hacker-fab/uw-spincoater/schematic/Spin_Coater.kicad_pcb

## KiCad design schematic/Spin_Coater.kicad_pcb (2026-05-23)

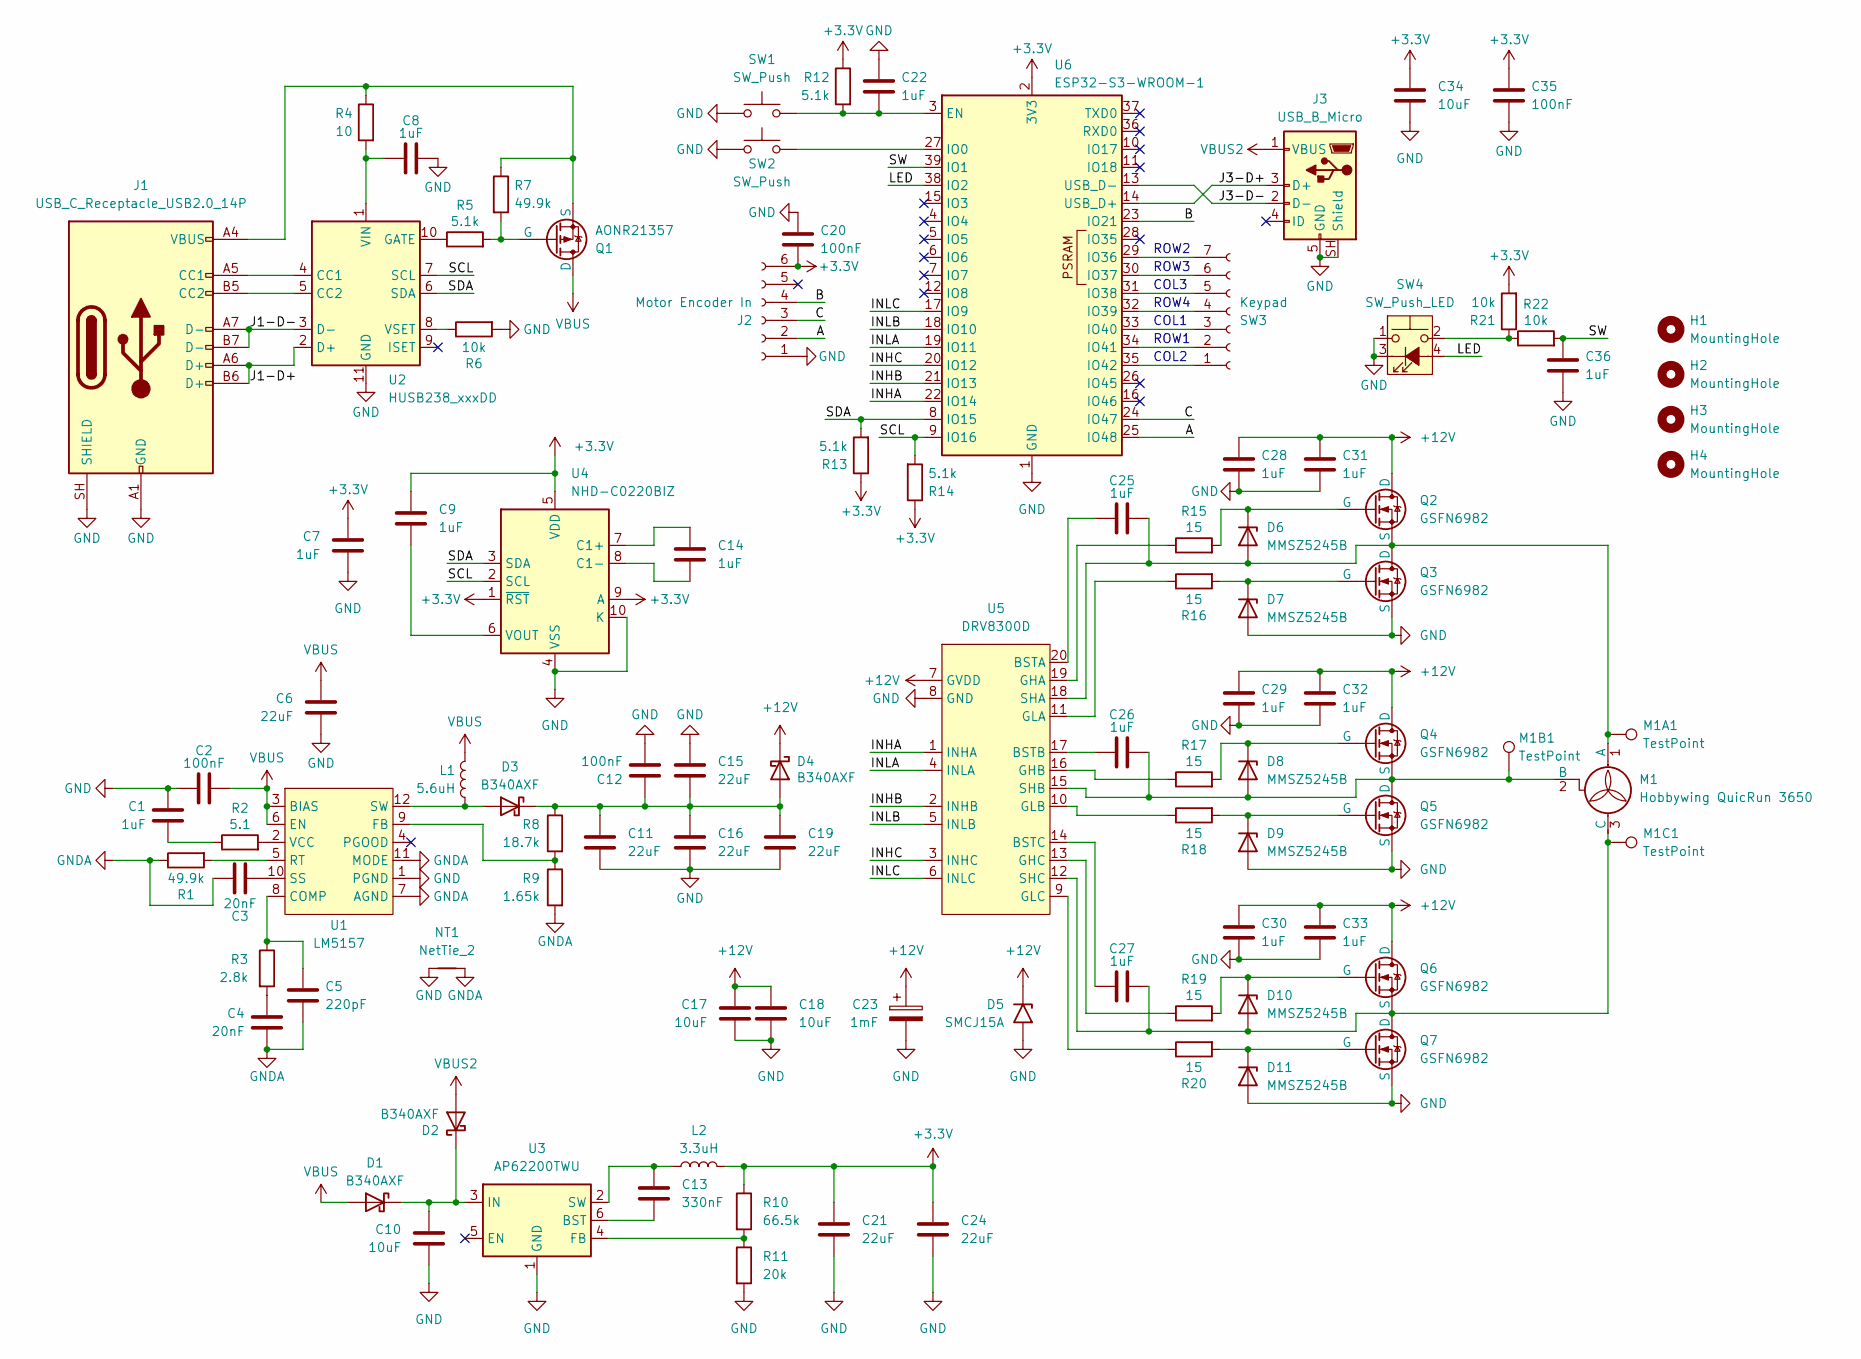
[picture p1: schematic Spin_Coater.kicad_sch, BLDC Proto]

Parts:
C1, C7, C8, C9, C14, C22, C25, C26, C27, C28, C29, C30, C31, C32, C33, C36: 1uF; C_0805_2012Metric
C2, C12, C20, C35: 100nF; C_0805_2012Metric
C3, C4: 20nF; C_0805_2012Metric
C5: 220pF; C_0805_2012Metric
C6, C11, C15, C16, C19, C21, C24: 22uF; C_1210_3225Metric
C10, C17, C18, C34: 10uF; C_1206_3216Metric
C13: 330nF; C_0805_2012Metric
C23: 1mF; CP_Radial_D13.0mm_P5.00mm
D1, D2, D3, D4: B340AXF; D_SMA
D5: SMCJ15A; D_SMC
D6, D7, D8, D9, D10, D11: MMSZ5245B; D_SOD-123
H1, H2, H3, H4: MountingHole; MountingHole_3.2mm_M3
J1: USB_C_Receptacle_USB2.0_14P; UJ20-C-H-G-SMT-2A-P16-TR
J2: Motor Encoder In; JST_ZH_B6B-ZR_1x06_P1.50mm_Vertical
J3: USB_B_Micro; UJ2-MIBH-G-SMT-TR
L1: 5.6uH; HPAL1V0630
L2: 3.3uH; HPC5040NF
M1: Hobbywing QuicRun 3650
M1A1, M1B1, M1C1: TestPoint; TestPoint_THTPad_D5.5mm_Drill3.5mm
NT1: NetTie_2; NetTie-2_SMD_Pad0.25mm
Q1: AONR21357; PPAK3x3
Q2, Q3, Q4, Q5, Q6, Q7: GSFN6982; PPAK3x3
R1, R7: 49.9k; R_0805_2012Metric
R2: 5.1; R_0805_2012Metric
R3: 2.8k; R_0805_2012Metric
R4: 10; R_0805_2012Metric
R5, R12, R13, R14: 5.1k; R_0805_2012Metric
R6, R21, R22: 10k; R_0805_2012Metric
R8: 18.7k; R_0805_2012Metric
R9: 1.65k; R_0805_2012Metric
R10: 66.5k; R_0805_2012Metric
R11: 20k; R_0805_2012Metric
R15, R16, R17, R18, R19, R20: 15; R_0805_2012Metric
SW1, SW2: SW_Push; SW_PUSH_6mm
SW3: Keypad; PinHeader_1x07_P2.54mm_Vertical
SW4: SW_Push_LED; PinSocket_2x02_P2.54mm_Vertical
U1: LM5157; WQFN-16-1EP_3x3mm_P0.5mm_EP1.68x1.68mm_ThermalVias
U2: HUSB238_xxxDD; WDFN-10-1EP_3x3mm_P0.5mm_EP1.8x2.5mm
U3: AP62200TWU; TSOT-23-6
U4: NHD-C0220BIZ; NHD-C0220BiZ
U5: DRV8300D; TSSOP-20_4.4x6.5mm_P0.65mm
U6: ESP32-S3-WROOM-1

Connections:
+3.3V: C7.1, C9.1, C20.2, C21.1, C24.1, C34.1, C35.1, J2.6, L2.2, R10.1, R12.1, R13.1, R14.1, R21.2, U4.1 (~RST), U4.5 (VDD), U4.9 (A), U6.2 (3V3)
+12V: C17.1, C18.1, C23.1, C28.1, C29.1, C30.1, C31.1, C32.1, C33.1, D4.1 (K), D5.1 (A1), Q2.5 (D), Q4.5 (D), Q6.5 (D), U5.7 (GVDD)
/A: J2.2, U6.25 (IO48)
/B: J2.4, U6.23 (IO21)
/C: J2.3, U6.24 (IO47)
/INHA: U5.1 (INHA), U6.22 (IO14)
/INHB: U5.2 (INHB), U6.21 (IO13)
/INHC: U5.3 (INHC), U6.20 (IO12)
/INLA: U5.4 (INLA), U6.19 (IO11)
/INLB: U5.5 (INLB), U6.18 (IO10)
/INLC: U5.6 (INLC), U6.17 (IO9)
/J1-D+: J1.A6 (D+), J1.B6 (D+), U2.2 (D+)
/J1-D-: J1.A7 (D-), J1.B7 (D-), U2.3 (D-)
/J3-D+: J3.3 (D+), U6.14 (USB_D+)
/J3-D-: J3.2 (D-), U6.13 (USB_D-)
/LED: SW4.4 (A), U6.38 (IO2)
/SCL: R14.2, U2.7 (SCL), U4.2 (SCL), U6.9 (IO16)
/SDA: R13.2, U2.6 (SDA), U4.3 (SDA), U6.8 (IO15)
/SW: C36.1, R22.2, U6.39 (IO1)
GND: C1.1, C2.1, C6.2, C7.2, C8.2, C10.2, C11.2, C12.2, C15.1, C16.2, C17.2, C18.2, C19.2, C20.1, C21.2, C22.1, C23.2, C24.2, C28.2, C29.2, C30.2, C31.2, C32.2, C33.2, C34.2, C35.2, C36.2, D5.2 (A2), D7.2 (A), D9.2 (A), D11.2 (A), J1.A1 (GND), J1.A12 (GND), J1.B1 (GND), J1.B12 (GND), J1.SH (SHIELD), J2.1, J3.5 (GND), J3.SH (Shield), NT1.1, Q3.1 (S), Q3.2 (S), Q3.3 (S), Q5.1 (S), Q5.2 (S), Q5.3 (S), Q7.1 (S), Q7.2 (S), Q7.3 (S), R6.2, R11.2, SW1.1, SW2.1, SW4.1, SW4.3 (K), U1.1 (PGND), U1.16 (PGND), U1.17 (PGND), U2.11 (GND), U3.1 (GND), U4.4 (VSS), U4.10 (K), U5.8 (GND), U6.1 (GND), U6.40 (GND), U6.41 (GND)
GNDA: C3.1, C4.2, C5.2, NT1.2, R1.1, R9.2, U1.7 (AGND), U1.11 (MODE)
unnamed: C1.2, R2.1
unnamed: C4.1, R3.2
unnamed: C10.1, D1.1 (K), D2.1 (K), U3.3 (IN)
unnamed: D3.2 (A), L1.2, U1.12 (SW), U1.13 (SW), U1.14 (SW)
unnamed: C11.1, C12.1, C15.2, C16.1, C19.1, D3.1 (K), D4.2 (A), R8.1
unnamed: C25.2, D6.2 (A), M1.1 (A), M1A1.1 (1_1), Q2.1 (S), Q2.2 (S), Q2.3 (S), Q3.5 (D), U5.18 (SHA)
unnamed: D6.1 (K), Q2.4 (G), R15.2
unnamed: D7.1 (K), Q3.4 (G), R16.2
unnamed: C26.2, D8.2 (A), M1.2 (B), M1B1.1 (1_1), Q4.1 (S), Q4.2 (S), Q4.3 (S), Q5.5 (D), U5.15 (SHB)
unnamed: D8.1 (K), Q4.4 (G), R17.2
unnamed: D9.1 (K), Q5.4 (G), R18.2
unnamed: C27.2, D10.2 (A), M1.3 (C), M1C1.1 (1_1), Q6.1 (S), Q6.2 (S), Q6.3 (S), Q7.5 (D), U5.12 (SHC)
unnamed: D10.1 (K), Q6.4 (G), R19.2
unnamed: D11.1 (K), Q7.4 (G), R20.2
unnamed: J1.A5 (CC1), U2.4 (CC1)
unnamed: J1.B5 (CC2), U2.5 (CC2)
unnamed: J1.A4 (VBUS), J1.A9 (VBUS), J1.B4 (VBUS), J1.B9 (VBUS), Q1.1 (S), Q1.2 (S), Q1.3 (S), R4.1, R7.1
unnamed: Q1.4 (G), R5.2, R7.2
unnamed: R21.1, R22.1, SW4.2
unnamed: SW3.1, U6.35 (IO42)
unnamed: SW3.2, U6.34 (IO41)
unnamed: SW3.3, U6.33 (IO40)
unnamed: SW3.4, U6.32 (IO39)
unnamed: SW3.5, U6.31 (IO38)
unnamed: SW3.6, U6.30 (IO37)
unnamed: SW3.7, U6.29 (IO36)
unnamed: C5.1, R3.1, U1.8 (COMP)
unnamed: R8.2, R9.1, U1.9 (FB)
unnamed: R1.2, U1.5 (RT)
unnamed: C3.2, U1.10 (SS)
unnamed: R2.2, U1.2 (VCC)
unnamed: R5.1, U2.10 (GATE)
unnamed: C8.1, R4.2, U2.1 (VIN)
unnamed: R6.1, U2.8 (VSET)
unnamed: C13.2, U3.6 (BST)
unnamed: R10.2, R11.1, U3.4 (FB)
unnamed: C13.1, L2.1, U3.2 (SW)
unnamed: C14.1, U4.7 (C1+)
unnamed: C14.2, U4.8 (C1-)
unnamed: C9.2, U4.6 (VOUT)
unnamed: C25.1, U5.20 (BSTA)
unnamed: C26.1, U5.17 (BSTB)
unnamed: C27.1, U5.14 (BSTC)
unnamed: R15.1, U5.19 (GHA)
unnamed: R17.1, U5.16 (GHB)
unnamed: R19.1, U5.13 (GHC)
unnamed: R16.1, U5.11 (GLA)
unnamed: R18.1, U5.10 (GLB)
unnamed: R20.1, U5.9 (GLC)
unnamed: C22.2, R12.2, SW1.2, U6.3 (EN)
unnamed: SW2.2, U6.27 (IO0)
VBUS: C2.2, C6.1, D1.2 (A), L1.1, Q1.5 (D), U1.3 (BIAS), U1.6 (EN)
VBUS2: D2.2 (A), J3.1 (VBUS)

Notes on the sheet:
ROW2
COL2
ROW3
ROW4
COL3
COL1
ROW1

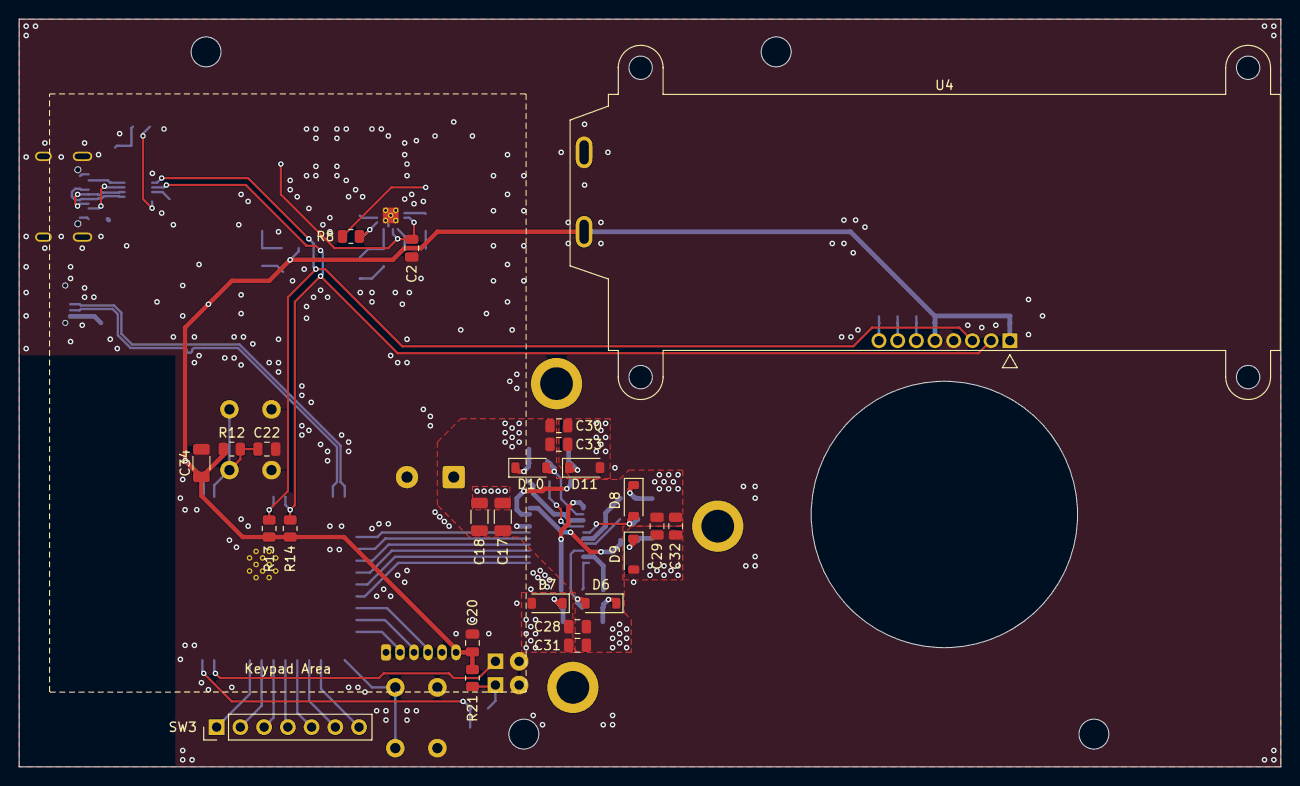
[picture p2: board Spin_Coater.kicad_pcb from above]

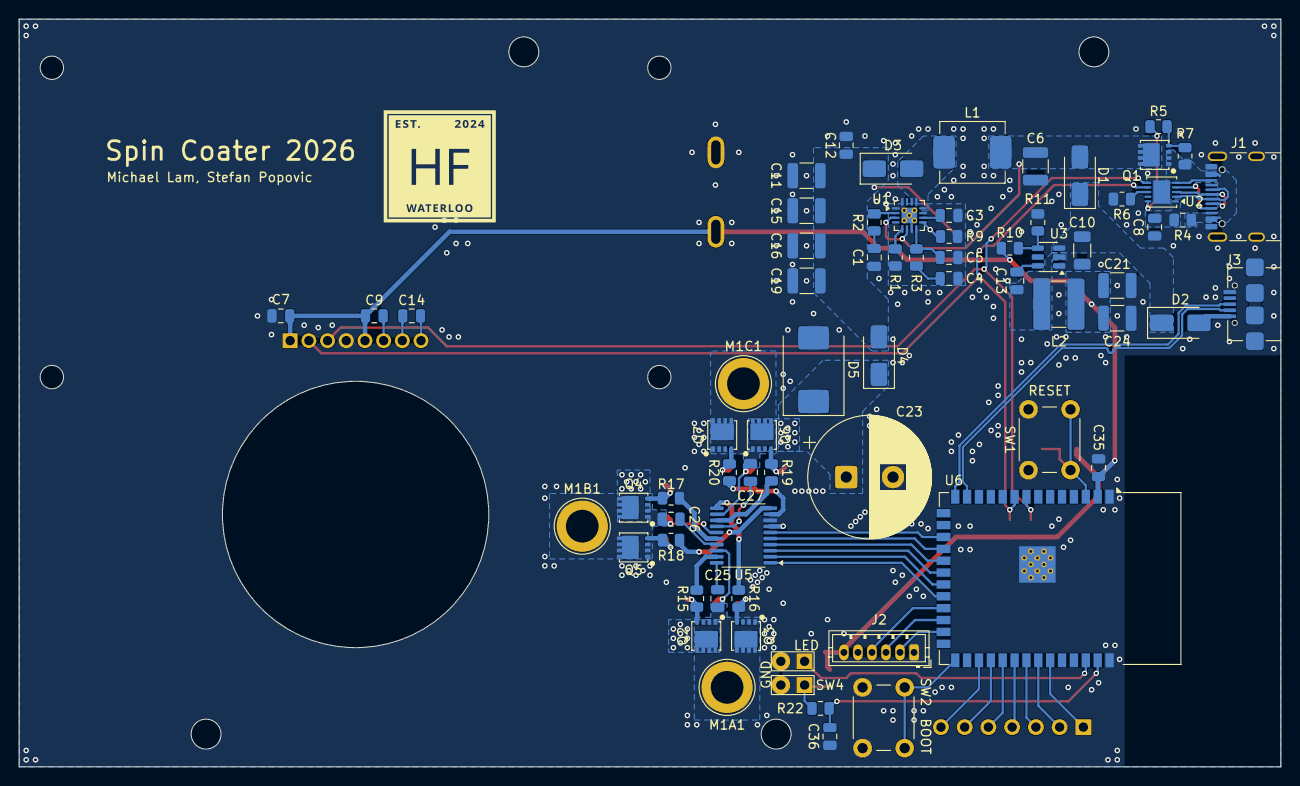
[picture p3: board Spin_Coater.kicad_pcb from below]

Board: 2 copper layers, 135.0 x 80.0 mm, 99 parts (70 on the bottom side), 74 nets.
