hacker-fab/uw-spincoater/BLDC_Proto/BLDC_Proto.kicad_pcb

## KiCad design BLDC_Proto/BLDC_Proto.kicad_pcb (2026-02-12)

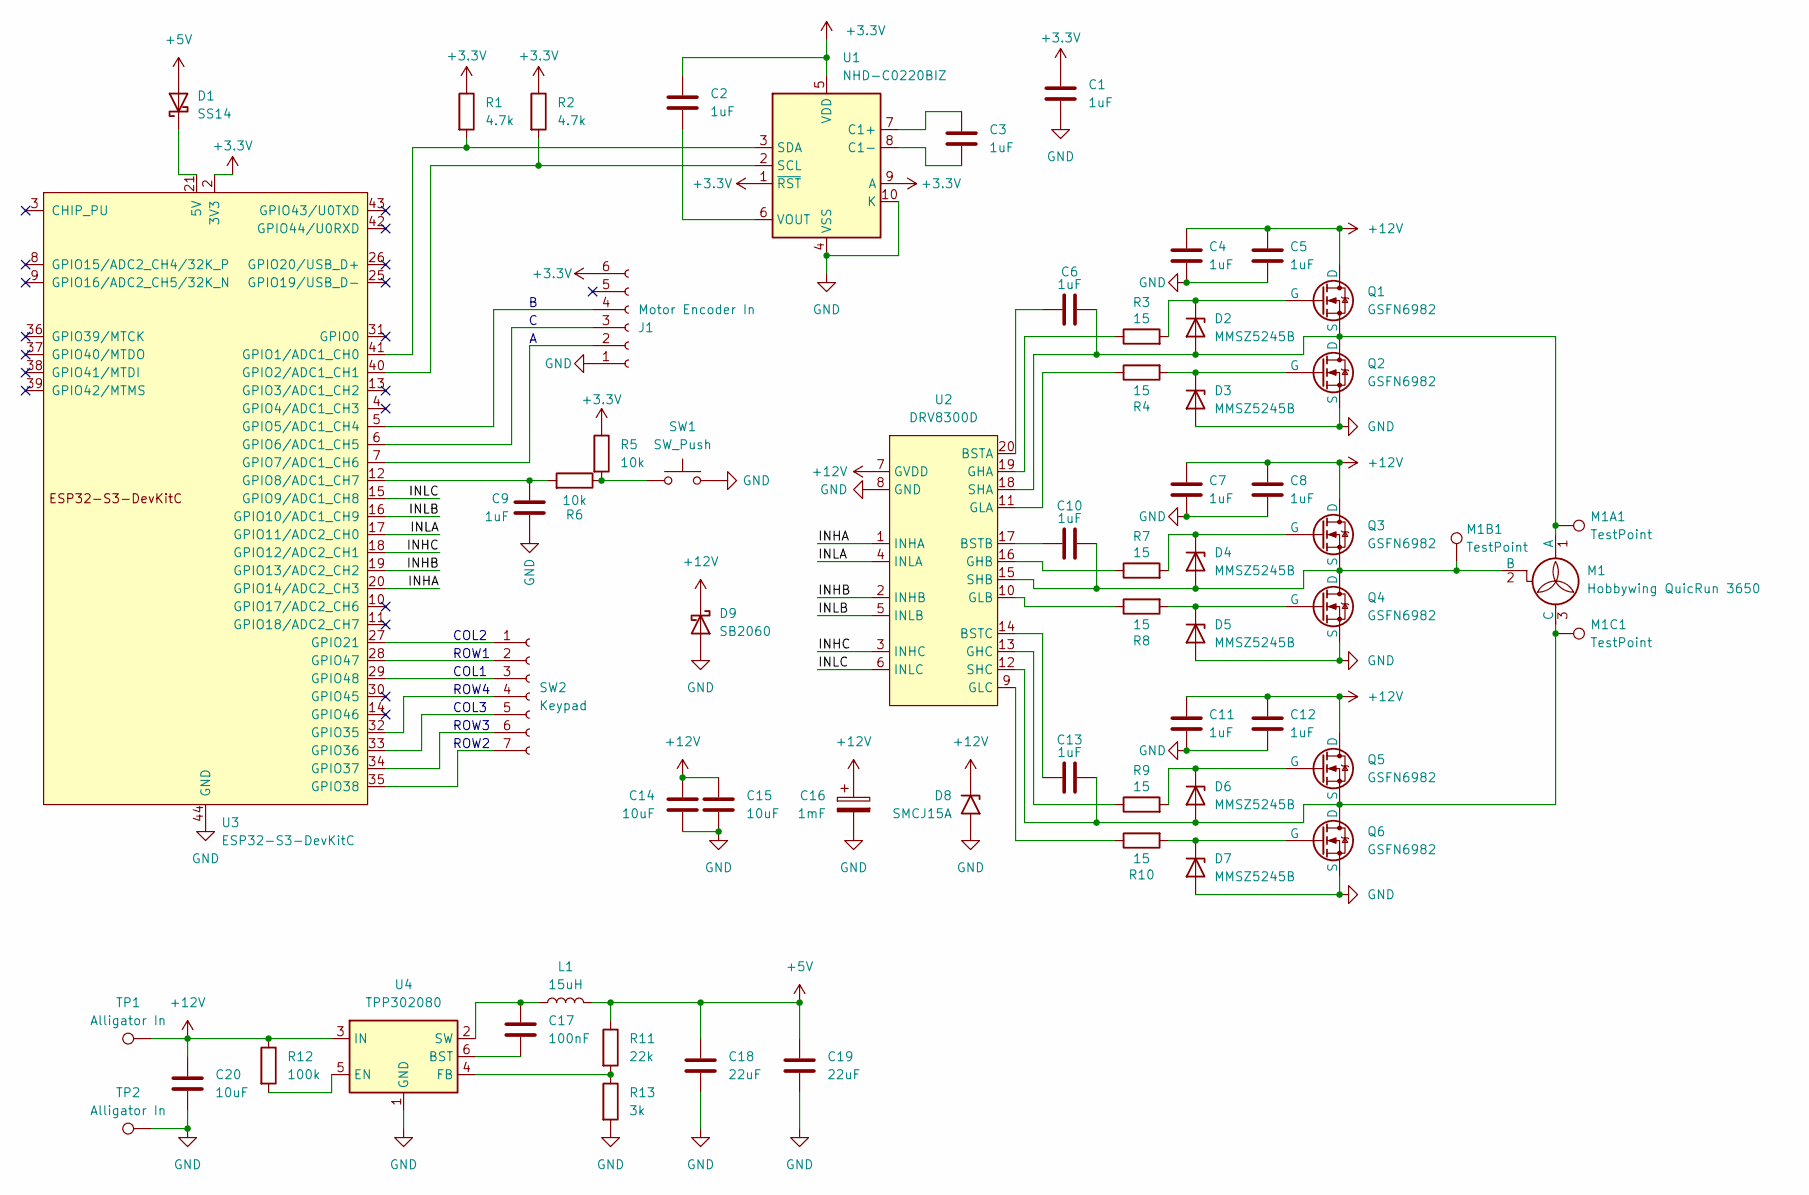
[picture p4: schematic BLDC_Proto.kicad_sch, BLDC Proto]

Parts:
C1, C2, C3, C4, C5, C6, C7, C8, C9, C10, C11, C12, C13: 1uF; C_0805_2012Metric
C14, C15, C20: 10uF; C_1206_3216Metric
C16: 1mF; CP_Radial_D13.0mm_P5.00mm
C17: 100nF; C_0805_2012Metric
C18, C19: 22uF; C_1210_3225Metric
D1: SS14; D_SMA
D2, D3, D4, D5, D6, D7: MMSZ5245B; D_SOD-123
D8: SMCJ15A; D_SMC
D9: SB2060; D_DO-201AD_P15.24mm_Horizontal
J1: Motor Encoder In; JST_ZH_B6B-ZR_1x06_P1.50mm_Vertical
L1: 15uH; HCM1A0805V3-150R
M1: Hobbywing QuicRun 3650
M1A1, M1B1, M1C1: TestPoint; TestPoint_THTPad_D5.0mm_Drill3.0mm
Q1, Q2, Q3, Q4, Q5, Q6: GSFN6982; PPAK3x3
R1, R2: 4.7k; R_0805_2012Metric
R3, R4, R7, R8, R9, R10: 15; R_0805_2012Metric
R5, R6: 10k; R_0805_2012Metric
R11: 22k; R_0805_2012Metric
R12: 100k; R_0805_2012Metric
R13: 3k; R_0805_2012Metric
SW1: SW_Push; SW_PUSH_6mm
SW2: Keypad; PinHeader_1x07_P2.54mm_Vertical
TP1, TP2: Alligator In; 1502-2 Turret
U1: NHD-C0220BIZ; NHD-C0220BiZ
U2: DRV8300D; TSSOP-20_4.4x6.5mm_P0.65mm
U3: ESP32-S3-DevKitC
U4: TPP302080; TSOT-23-6

Connections:
+3.3V: C1.1, C2.1, J1.6, R1.1, R2.1, R5.1, U1.1 (~RST), U1.5 (VDD), U1.9 (A), U3.1 (3V3), U3.2 (3V3)
+5V: C18.1, C19.1, D1.2 (A), L1.2, R11.1
+12V: C4.1, C5.1, C7.1, C8.1, C11.1, C12.1, C14.1, C15.1, C16.1, C20.1, D8.1 (A1), D9.1 (K), Q1.5 (D), Q3.5 (D), Q5.5 (D), R12.1, TP1.1, U2.7 (GVDD), U4.3 (IN)
/INHA: U2.1 (INHA), U3.20 (GPIO14/ADC2_CH3)
/INHB: U2.2 (INHB), U3.19 (GPIO13/ADC2_CH2)
/INHC: U2.3 (INHC), U3.18 (GPIO12/ADC2_CH1)
/INLA: U2.4 (INLA), U3.17 (GPIO11/ADC2_CH0)
/INLB: U2.5 (INLB), U3.16 (GPIO10/ADC1_CH9)
/INLC: U2.6 (INLC), U3.15 (GPIO9/ADC1_CH8)
GND: C1.2, C4.2, C5.2, C7.2, C8.2, C9.2, C11.2, C12.2, C14.2, C15.2, C16.2, C18.2, C19.2, C20.2, D3.2 (A), D5.2 (A), D7.2 (A), D8.2 (A2), D9.2 (A), J1.1, Q2.1 (S), Q2.2 (S), Q2.3 (S), Q4.1 (S), Q4.2 (S), Q4.3 (S), Q6.1 (S), Q6.2 (S), Q6.3 (S), R13.2, SW1.2, TP2.1, U1.4 (VSS), U1.10 (K), U2.8 (GND), U3.22 (GND), U3.23 (GND), U3.24 (GND), U3.44 (GND), U4.1 (GND)
unnamed: D1.1 (K), U3.21 (5V)
unnamed 11: C6.2, D2.2 (A), M1.1 (A), M1A1.1, Q1.1 (S), Q1.2 (S), Q1.3 (S), Q2.5 (D), U2.18 (SHA); also elsewhere on the board
unnamed: D2.1 (K), Q1.4 (G), R3.2
unnamed: D3.1 (K), Q2.4 (G), R4.2
unnamed 14: C10.2, D4.2 (A), M1.2 (B), M1B1.1, Q3.1 (S), Q3.2 (S), Q3.3 (S), Q4.5 (D), U2.15 (SHB); also elsewhere on the board
unnamed: D4.1 (K), Q3.4 (G), R7.2
unnamed: D5.1 (K), Q4.4 (G), R8.2
unnamed 17: C13.2, D6.2 (A), M1.3 (C), M1C1.1, Q5.1 (S), Q5.2 (S), Q5.3 (S), Q6.5 (D), U2.12 (SHC); also elsewhere on the board
unnamed: D6.1 (K), Q5.4 (G), R9.2
unnamed: D7.1 (K), Q6.4 (G), R10.2
unnamed: J1.2, U3.7 (GPIO7/ADC1_CH6)
unnamed: J1.3, U3.6 (GPIO6/ADC1_CH5)
unnamed: J1.4, U3.5 (GPIO5/ADC1_CH4)
unnamed: R5.2, R6.1, SW1.1
unnamed: SW2.1, U3.27 (GPIO21)
unnamed: SW2.2, U3.28 (GPIO47)
unnamed: SW2.3, U3.29 (GPIO48)
unnamed: SW2.4, U3.32 (GPIO35)
unnamed: SW2.5, U3.33 (GPIO36)
unnamed: SW2.6, U3.34 (GPIO37)
unnamed: SW2.7, U3.35 (GPIO38)
unnamed: C3.1, U1.7 (C1+)
unnamed: C3.2, U1.8 (C1-)
unnamed: R2.2, U1.2 (SCL), U3.40 (GPIO2/ADC1_CH1)
unnamed: R1.2, U1.3 (SDA), U3.41 (GPIO1/ADC1_CH0)
unnamed: C2.2, U1.6 (VOUT)
unnamed: C6.1, U2.20 (BSTA)
unnamed: C10.1, U2.17 (BSTB)
unnamed: C13.1, U2.14 (BSTC)
unnamed: R3.1, U2.19 (GHA)
unnamed: R7.1, U2.16 (GHB)
unnamed: R9.1, U2.13 (GHC)
unnamed: R4.1, U2.11 (GLA)
unnamed: R8.1, U2.10 (GLB)
unnamed: R10.1, U2.9 (GLC)
unnamed: C9.1, R6.2, U3.12 (GPIO8/ADC1_CH7)
unnamed: C17.2, U4.6 (BST)
unnamed: R12.2, U4.5 (EN)
unnamed: R11.2, R13.1, U4.4 (FB)
unnamed: C17.1, L1.1, U4.2 (SW)

Notes on the sheet:
ROW2
COL2
ROW3
ROW4
COL3
COL1
ROW1

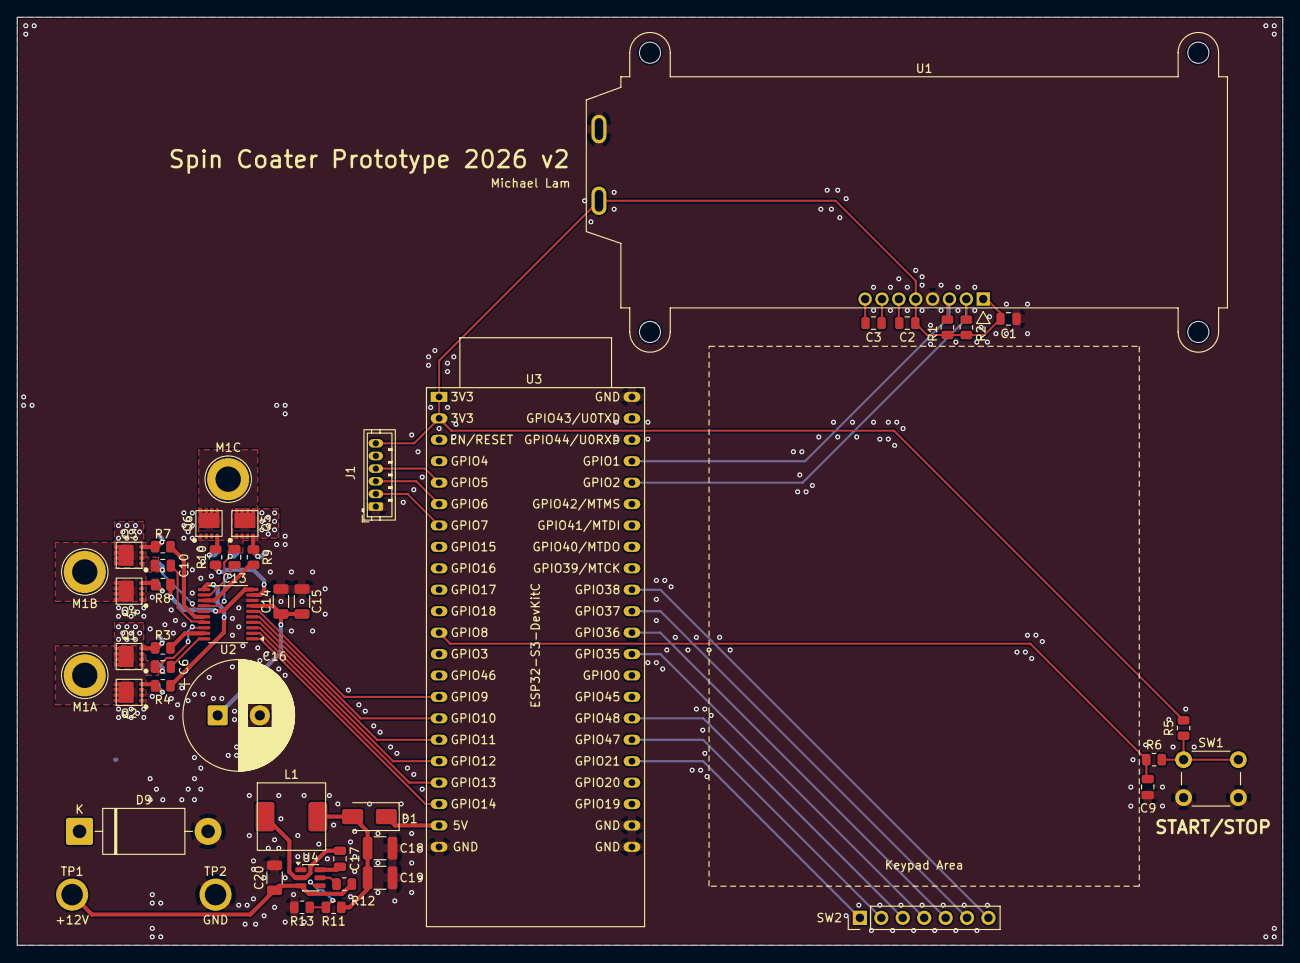
[picture p5: board BLDC_Proto.kicad_pcb from above]

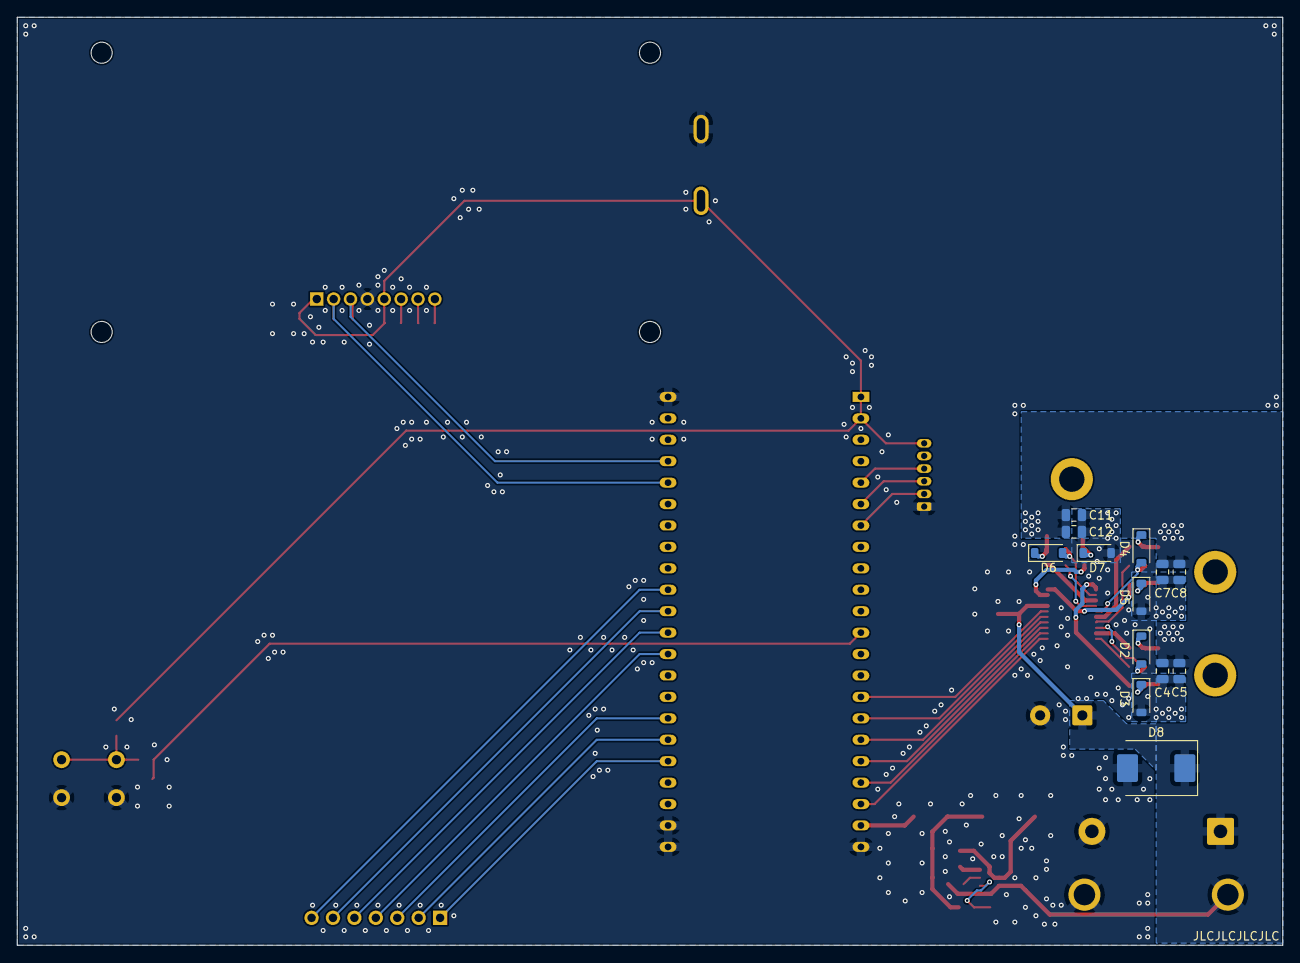
[picture p6: board BLDC_Proto.kicad_pcb from below]

Board: 2 copper layers, 150.0 x 110.0 mm, 61 parts (13 on the bottom side), 50 nets.

Other parts of the board:
M1A, M1B, M1C: TestPoint; TestPoint_THTPad_D5.0mm_Drill3.0mm

Their connections:
unnamed 11: M1A.1; also elsewhere on the board
unnamed 14: M1B.1; also elsewhere on the board
unnamed 17: M1C.1; also elsewhere on the board
