hacker-fab/uw-spincoater/(commit log)

2026-02-11 First Revision (DO NOT USE)
    [BLDC_Proto.kicad_pcb, BLDC_Proto.kicad_sch]
2026-02-12 2nd iteration
    [BLDC_Proto.kicad_pcb, BLDC_Proto.kicad_sch]
2026-02-12 Fix typo
    [BLDC_Proto.kicad_sch]
2026-02-12 Replace gate driver decoupling capacitor
    [BLDC_Proto.kicad_pcb, BLDC_Proto.kicad_sch]
2026-03-31 Working prototype
2026-05-12 New Version
    [Spin_Coater-B_Cu.gbr, Spin_Coater-B_Mask.gbr, Spin_Coater-B_Paste.gbr, Spin_Coater-B_Silkscreen.gbr, Spin_Coater-Edge_Cuts.gbr, Spin_Coater-F_Cu.gbr, Spin_Coater-F_Mask.gbr, Spin_Coater-F_Paste.gbr]
2026-05-19 Added button debouncing
    [BLDC_Proto.kicad_pcb, BLDC_Proto.kicad_sch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]
2026-05-23 Hopefully final revision
    [Spin_Coater-B_Cu.gbr, Spin_Coater-B_Mask.gbr, Spin_Coater-B_Paste.gbr, Spin_Coater-B_Silkscreen.gbr, Spin_Coater-Edge_Cuts.gbr, Spin_Coater-F_Cu.gbr, Spin_Coater-F_Mask.gbr, Spin_Coater-F_Paste.gbr]
2026-05-26 Added timer
